suvancabraal/SPACL/README.md

# SPACL
The Soil–Plant–Atmosphere Continuum Logger: A Modular System for Ecohydrological Model Calibration and Remote Sensing Validation
