suvancabraal/SPACL/spacl_bom.xlsx

SPACL BOM
Use this spreadsheet to:
- Purchase components to build SPACL
- Calculate the cost to buld X units of SPACL |  |  |  |  |  |  |  |  |  |  | Item | Total (USD) | Description
- Compute your savings for building in bulk vs per unit |  |  |  |  |  |  |  |  |  |  | One SPACL unit cost (no sensors) = | $149.65 | this is the cost of 1 SPACL unit at the cost per unit price. It does not consider the cost of items sold in bulk
 |  |  |  |  |  |  |  |  |  |  | Bulk SPACL cost (no sensors) = | $284.96 | this is the total cost to build X number of SPACL units. It does includes the cost of items sold in bulk
USER INPUT |  | change to the number of: |  |  |  |  |  |  |  |  | SPACL savings from building in bulk = | -$135.31 | this is how much you save from build X number of SPACL units, versus a single unit
# of SPACL = | 1 | SPACL units you wish to build |  |  |  |  |  |  |  |  | SPACL + N sensor set(s) = | $3285.04 | this is the cost of 1 SPACL unit with sensors for N compartments. It does not consider the cost of items sold in bulk
# of Compartments = | 3 | compartments to measure i.e. roots, stem, and branch = 3 |  |  |  |  |  |  |  |  | Total cost of loggers + sensors = | $3442.58 | this is the total cost to build X number of SPACL with N compartments per SPACL. It does include the cost of items sold in bulk
# of Soil Sensors = | 4 | soil depth to measure i.e. 10, 40, 100, 200cm = 4 |  |  |  |  |  |  |  |  | Total savings = | -$157.54 | this is the total project savings from building in bulk. It will vary with the number of SPACL units, compartments, and soil sensors
Type | Designator | Component | Number | Cost per unit (USD) | Total cost (USD) | Units/Order | Qnty to Order | Price/Order (USD) | Total Order (USD) | Store | Online Name | Source of Materials
Hardware | ENC | IP67 Waterproof Enclosure | 1 | $24.99 | $24.99 | 1 | 1 | $24.99 | $24.99 | Amazon | Junction Box, IP67 Waterproof Plastic Enclosure for Electrical Project, Hinged Grey Cover, Includes Mounting Plate and Wall Bracket 290×190×140mm (11.4"×7.5"×5.5") | https://www.amazon.com/dp/B08282SQPT?s=hi&sp_csd=d2lkZ2V0TmFtZT1zcF9kZXRhaWw
Hardware | NPT | ½ in NPT Cable Gland | 5 | $1.09 | $5.46 | 100 | 1 | $21.84 | $21.84 | Amazon | 100pcs Waterproof PG7 Cable Gland Connector Black Plastic Adjustable IP68 M12 Thread Cable Gland with Locknut Rubber Ring for 3.5-6mm Wire | https://www.amazon.com/Waterproof-Connector-Plastic-Adjustable-Locknut/dp/B078RHZNQL?s=hi
Hardware | Straps | Project Box Straps | 2 | $3.92 | $7.84 | 10 | 1 | $19.59 | $19.59 | Amazon | 10 Pack Lashing Straps 16ft x 1" Tie Down Straps Cam Buckle Straps Heavy Duty Secure Straps up to 600 lbs | https://www.amazon.com/Lashing-Straps-Black-Heavy-Buckle/dp/B08923M25W
Hardware | PVC-F | White ¾ in PVC elbow, 90 degree, female threads | 1 | $0.55 | $0.55 | 1 | 1 | $0.55 | $0.55 | PVC Fittings Online | 3/4" x 1/2" Schedule 40 PVC Reducing Male Adapter - MIPT x Socket (436-101) | https://www.pvcfittingsonline.com/products/436-101-3-4-x-1-2-schedule-40-pvc-reducing-male-adapter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
Hardware | PVC-M | White ¾" x ½" reducing male adapters | 1 | $0.51 | $0.51 | 1 | 1 | $0.51 | $0.51 | PVC Fittings Online | 3/4" Sch 40 PVC 90 Elbow - Soc x Fipt 407-007 | https://www.pvcfittingsonline.com/products/407-007-3-4-schedule-40-pvc-90-ell?variant=46481439621364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
Hardware | FWM | Fine Wire Mesh Screen | 1 | $0.13 | $0.13 | 60 | 1 | $7.75 | $7.75 | Amazon | Wire Mesh 304 Stainless Steel Fine Wires Meshes Sheets Wire Screen Roll for DIY Projects Cage Vent Garden Window Screen 34 X 120 CM | https://www.amazon.com/Stainless-Meshes-Sheets-Screen-Projects/dp/B0F656JB4Y?s=hi
Hardware | WZT | White Zip Ties | 1 | $0.04 | $0.04 | 100 | 1 | $3.99 | $3.99 | Amazon | 8 Inch Zip Cable Ties (100 Pieces), Self-Locking Premium Nylon Cable Wire Ties,Heavy Duty White, for Indoor and Outdoor by Boacua | https://www.amazon.com/Pieces-Self-Locking-Premium-Outdoor-Boacua/dp/B09KMYZMNT?s=hi
Hardware | DSV | Double Sided Velcro Strips | 3 | $1.31 | $3.93 | 40 | 1 | $17.46 | $17.46 | Amazon | VELCRO Brand Extreme Outdoor Mounting Tape | 20Ft x 1 In, Holds 15 lbs | Strong Heavy Duty Stick on Adhesive | Mount on Brick, Concrete for Hanging, 30702 | https://www.amazon.com/VELCRO-Brand-Mounting-Adhesive-Concrete/dp/B09BNPHCZX?s=hi
Hardware | DSC | Duct Seal Compound | 1 | $0.05 | $0.05 | 100 | 1 | $5.09 | $5.09 | Amazon | Rectorseal 81880 1-Pound Duct Seal Compound Gray | https://www.amazon.com/Rectorseal-81880-1-Pound-Duct-Compound/dp/B008A3UG94?s=hi
PCB | PCB | SPACL PCB | 1 | $3.32 | $3.32 | 10 | 1 | $33.24 | $33.24 | PCBWay | Custom PCB - Upload GERBER Files | https://www.pcbway.com/orderonline.aspx
PCB Component | U1/U2 | Arduino Nano v3 | 2 | $10.66 | $21.32 | 3 | 1 | $15.99 | $15.99 | Amazon | HiLetgo 3pcs Nano V3.0 ATmega328P CH340G 5V 16M Mini USB Micro Controller Board Development Board with PIN Headers Pin Unsoldered | https://www.amazon.com/HiLetgo-ATmega328P-Controller-Development-Unsoldered/dp/B01DLIJQA2?s=electronics
PCB Component | U3 | DS3231 RTC Module | 1 | $3.79 | $3.79 | 2 | 1 | $7.59 | $7.59 | Amazon | 2PCS DS3231 Real Time Clock Module RTC Clock Memory Module 3.3V/5V for Raspberry Pi (2PCS Yellow) | https://www.amazon.com/AOICRIE-DS3231-Module-Memory-Raspberry/dp/B09STGJBGG?s=electronics
PCB Component | BC | Buck Converter | 3 | $3.90 | $11.69 | 10 | 1 | $12.99 | $12.99 | Amazon | 10 Pack LM2596 DC-DC Buck Converter Step Down Module Power Supply DIP Output 1.25V-30V 3A | https://www.amazon.com/gp/product/B07VVXF7YX/ref=ewc_pr_img_1?smid=A84L3DR48II7S&th=1
PCB Component | SDM | SD Card Module | 1 | $0.90 | $0.90 | 10 | 1 | $8.99 | $8.99 | Amazon | 10PCS Micro SD SDHC TF Card Adapter Reader Module with SPI Interface Level Conversion Chip for Arduino | https://www.amazon.com/ANMBEST-Adapter-Interface-Conversion-Arduino/dp/B08CMLG4D6
PCB Component | 2TB | 2 Pin Terminal Block | 3 | $1.89 | $5.67 | 1 | 3 | $0.63 | $1.89 | Phoenix Enterprises | 2 pin Terminal Block .200" sp .398"ht | https://www.peconnectors.com/terminal-blocks-headers-plugs/hws16542/
PCB Component | 3TB | 3 Pin Terminal Block | 4 | $2.56 | $10.24 | 1 | 4 | $0.64 | $2.56 | Phoenix Enterprises | 3 pin Terminal Block 5.0mm sp | https://www.peconnectors.com/terminal-blocks-headers-plugs/hws4676/
PCB Component | 4TB | 4 Pin Terminal Block | 1 | $1.06 | $1.06 | 1 | 1 | $1.06 | $1.06 | On Shore Technology Inc. | TERM BLK 4P SIDE ENT 5.08MM PCB; OSTTC042162 (Manufacturer Product No.) | https://www.digikey.com/en/products/detail/on-shore-technology-inc/OSTTC042162/614560
PCB Component | 1x6FH | 1x6 Pin Female Header | 2 | $0.72 | $1.44 | 1 | 2 | $0.36 | $0.72 | Phoenix Enterprises | 1x 6 pin Female Header .1"sp | https://www.peconnectors.com/female-headers-pcb-1x-row-.100/hws1068/
PCB Component | 1x10FH | 1x10 Pin Female Header | 1 | $0.46 | $0.46 | 1 | 1 | $0.46 | $0.46 | Phoenix Enterprises | 1x10 pin Female Header .1"sp | https://www.peconnectors.com/female-headers-pcb-1x-row-.100/hws15772/
PCB Component | 1x15FH | 1x15 Pin Female Header | 4 | $2.48 | $9.92 | 1 | 4 | $0.62 | $2.48 | Phoenix Enterprises | 1x15 pin Female Header .1"sp | https://www.peconnectors.com/female-headers-pcb-1x-row-.100/hws1879/
PCB Component | SDC | SD Card | 1 | $5.50 | $5.50 | 2 | 1 | $10.99 | $10.99 | Amazon | Pack of 2 Micro SD Card 4GB Flash Memory Card C6 Micro SDHC with SD Adapter (4 GB) | https://www.amazon.com/Cloudisk-Micro-Flash-Memory-Adapter/dp/B0D2T7ZTNG?s=electronics
PCB Component | RM | 5V Relay Module | 1 | $1.75 | $1.75 | 4 | 1 | $6.99 | $6.99 | Amazon | 4pcs DC 5V Relay Module - 1 Channel Relay Switch Board with Optocoupler Isolation, High or Low Level Trigger | https://www.amazon.com/AEDIKO-Channel-Optocoupler-Isolation-Support/dp/B095YD3732
PCB Component | RF | 433MHz RF Module (RF) | 1 | $2.00 | $2.00 | 5 | 1 | $9.99 | $9.99 | Amazon | 5pcs 433mhz Wireless RF Transmitter and Receiver with Antenna Ask Remote Control Module DIY Kit for Arduino | https://www.amazon.com/D-FLIFE-Wireless-Transmitter-Receiver-Antenna/dp/B0BZRRBBNK
Power | BAT | 12V 24Ah Battery | 1 | $24.99 | $24.99 | 2 | 1 | $49.98 | $49.98 | Amazon | Miady 12V 12 Ah Rechargeable Sealed Lead Acid Battery (12a-2 Packs) | https://www.amazon.com/Miady-Rechargeable-Sealed-Battery-12a-2/dp/B0FCFL82J4?sp_csd=d2lkZ2V0TmFtZT1zcF9hdGY
Power | TPIN | Battery Pins | 4 | $0.25 | $1.01 | 100 | 1 | $6.29 | $6.29 | Amazon | Baomain 100-Pack 1/4" Female Quick Disconnect Spade Terminals, 16-14 AWG 6.3mm (0.25 inch), Insulated Crimp Connectors Blue | https://www.amazon.com/Baomain-disconnects-Insulated-Connector-Electrical/dp/B01G4POUAU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
Power | 20AWG | 20AWG Wire | 1 | $1.10 | $1.10 | 10 | 1 | $10.98 | $10.98 | Amazon | BNTECHGO 20 Gauge Silicone Wire Spool red 25ft and Black 25ft Flexible 20 AWG Stranded Tinned Copper Wire | https://www.amazon.com/BNTECHGO-Silicone-Flexible-Strands-Stranded/dp/B07HGTHTKT?hvadid=80608026542635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
Sensor | MCP9600 | MCP9600 Thermocouple Breakout Board | 1 | $15.95 | $15.95 | 1 | 3 | $15.95 | $47.85 | Adafruit | Adafruit MCP9600 I2C Thermocouple Amplifier - K, J, T, N, S, E, B and R Type T | https://www.adafruit.com/product/4101
Sensor | TEROS-12 | Teros-12 Soil Moisture Sensor | 1 | $256.00 | $256.00 | 1 | 3 | $256.00 | $768.00 | METER Group Inc. | TEROS 12 Advanced Soil Moisture Sensor + Temperature and EC | https://metergroup.com/products/teros-12/
Sensor | uTen | Analog microTensiometer probe with SDI-12 Box | 1 | $700.00 | $700.00 | 1 | 3 | $700.00 | $2100.00 | FloraPulse Co | FloraPulse MicroTensiometer | https://florapulse.com/for-scientists/
Sensor | VH400 | VH400 Soil Moisture Probe | 1 | $51.95 | $51.95 | 1 | 4 | $51.95 | $207.80 | Vegetronix | VH400-5M | https://www.vegetronix.com/Products/VH400/
Sensor | BME280 | BME280 T/P/RH Module | 1 | $5.25 | $5.25 | 4 | 1 | $20.98 | $20.98 | Amazon | BME280 Digital 5V Temperature Humidity Sensor,Atmospheric Barometric Pressure Board with IIC I2C Breakout for Arduino(4 Pack) | https://www.amazon.com/dp/B07KR24P6P?s=industrial&sp_csd=d2lkZ2V0TmFtZT1zcF9kZXRhaWw
Sensor | VEML7700 | VEML7700 Light Sensor | 1 | $6.50 | $6.50 | 2 | 1 | $12.99 | $12.99 | Amazon | HiLetgo 2pcs VEML7700 Ambient Light Sensor Module I2C IIC 16 Bits Light Environment Sensor 0~120k Lux Light Measuring Range | https://www.amazon.com/dp/B07KR24P6P?s=industrial&sp_csd=d2lkZ2V0TmFtZT1zcF9kZXRhaWw
