suvancabraal/SPACL/spacl_schematic.pdf

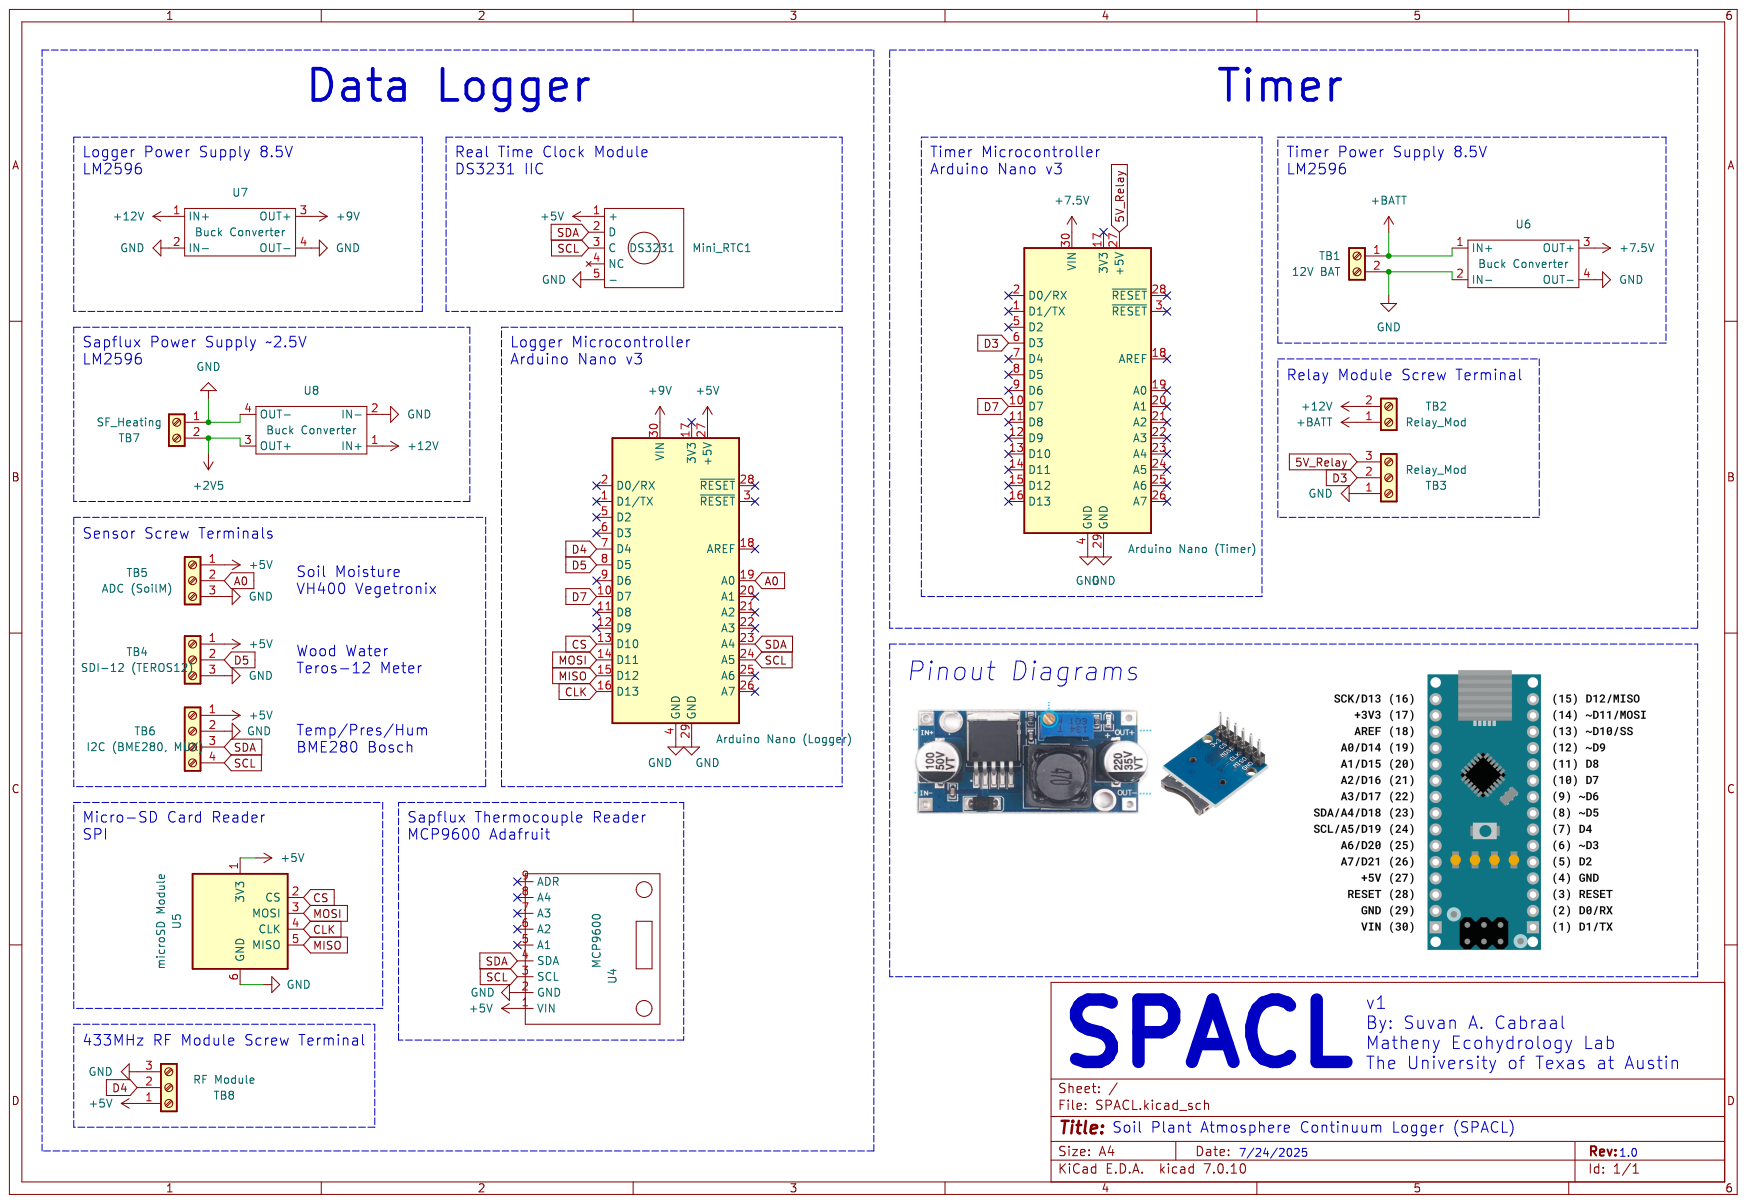
[picture p1: page 1]
