suvancabraal/SPACL/spacl_pcb.pdf

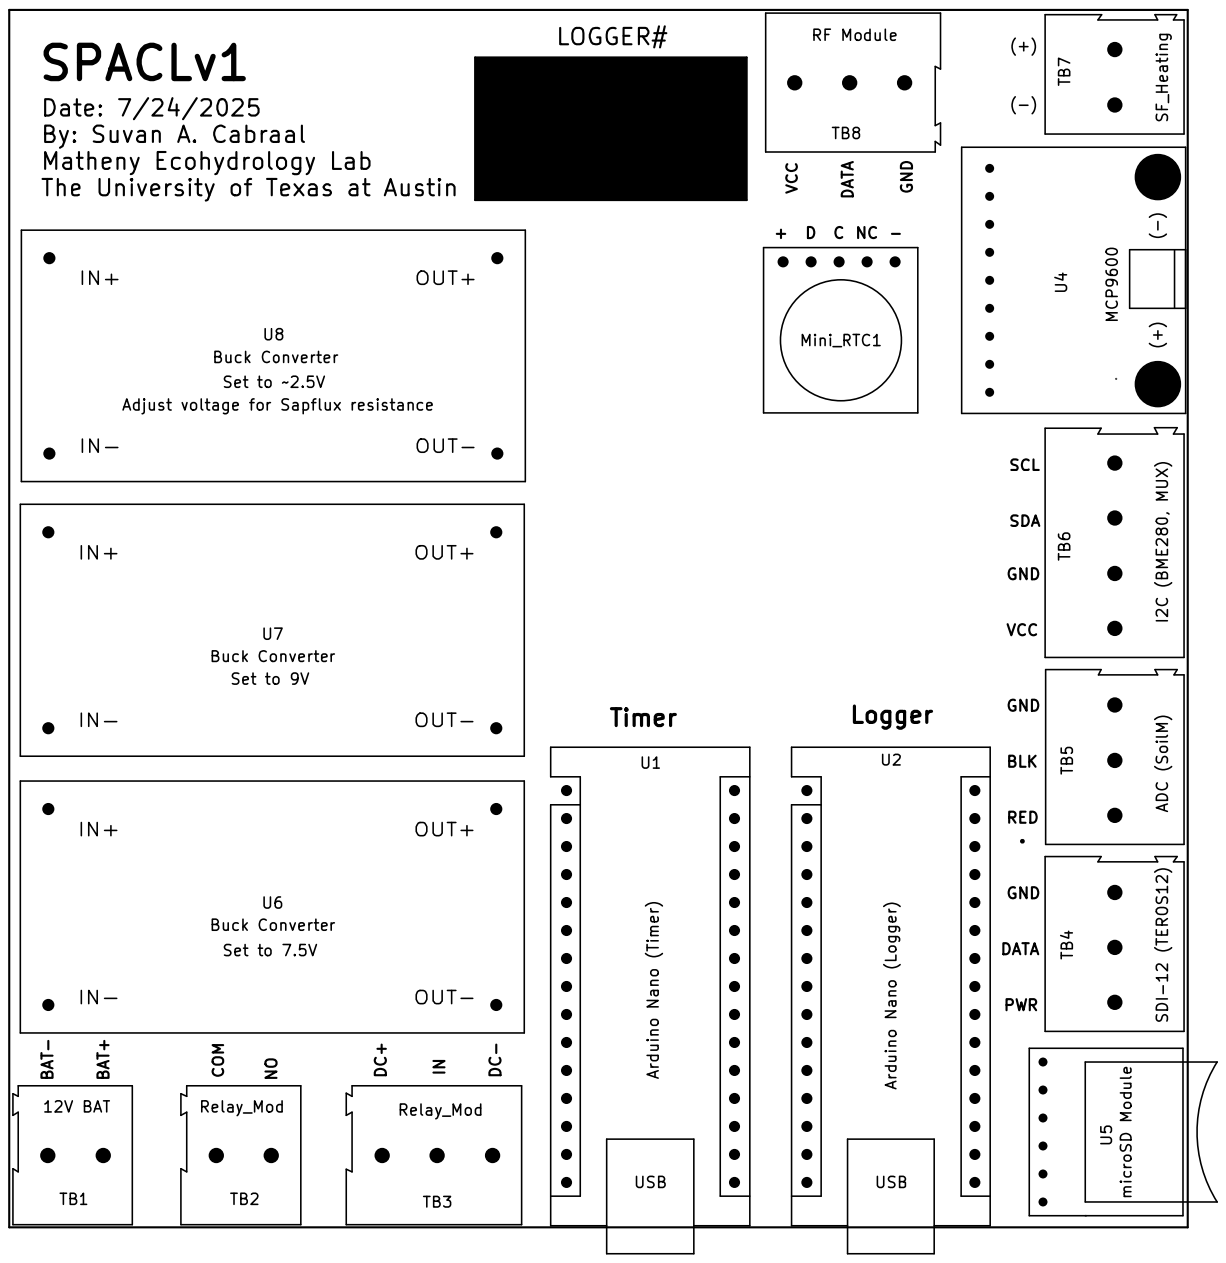
[picture p2: page 1]
